valmat/BatterySensor/README.md

BatterySensor
=======
This is my personal Arduino project. Its purpose is to expand the functionality of the battery for the boat motor.

Used libraries:

*	[Pino](https://github.com/valmat/Pino)
*	[LiquidCrystal](https://github.com/arduino/Arduino/tree/master/libraries/LiquidCrystal)
*	[RBD_Button](https://github.com/alextaujenis/RBD_Button)
*	[RBD_Timer](https://github.com/alextaujenis/RBD_Timer)
*	[Wire](https://www.arduino.cc/en/Reference/Wire)
*	[Adafruit_BMP085_Library](https://github.com/adafruit/Adafruit-BMP085-Library)

Documentation is [here](https://github.com/valmat/BatterySensor/tree/master/docs) (russian)

---

Это мой персональный Aрдуино проект. Его предназначение заключается в расширении функциональности для лодочного матора.
Подробнее см. [моем блоге](http://www.valmat.ru/2016/02/batterySensor.html)
