valmat/BatterySensor/docs/my-pinout2.png

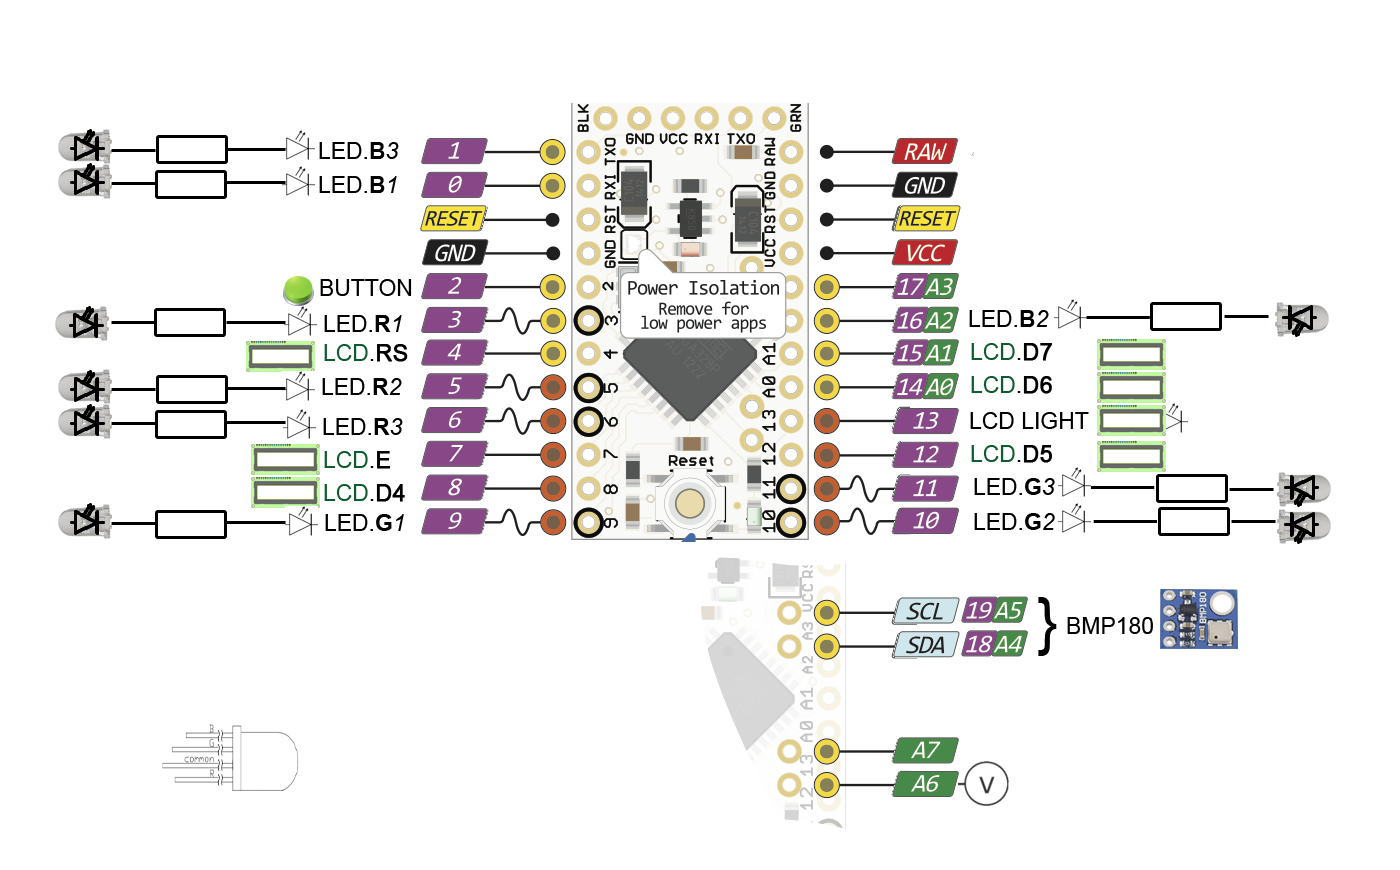
docs/my-pinout2.png
