valmat/BatterySensor/docs/my-pinout.png

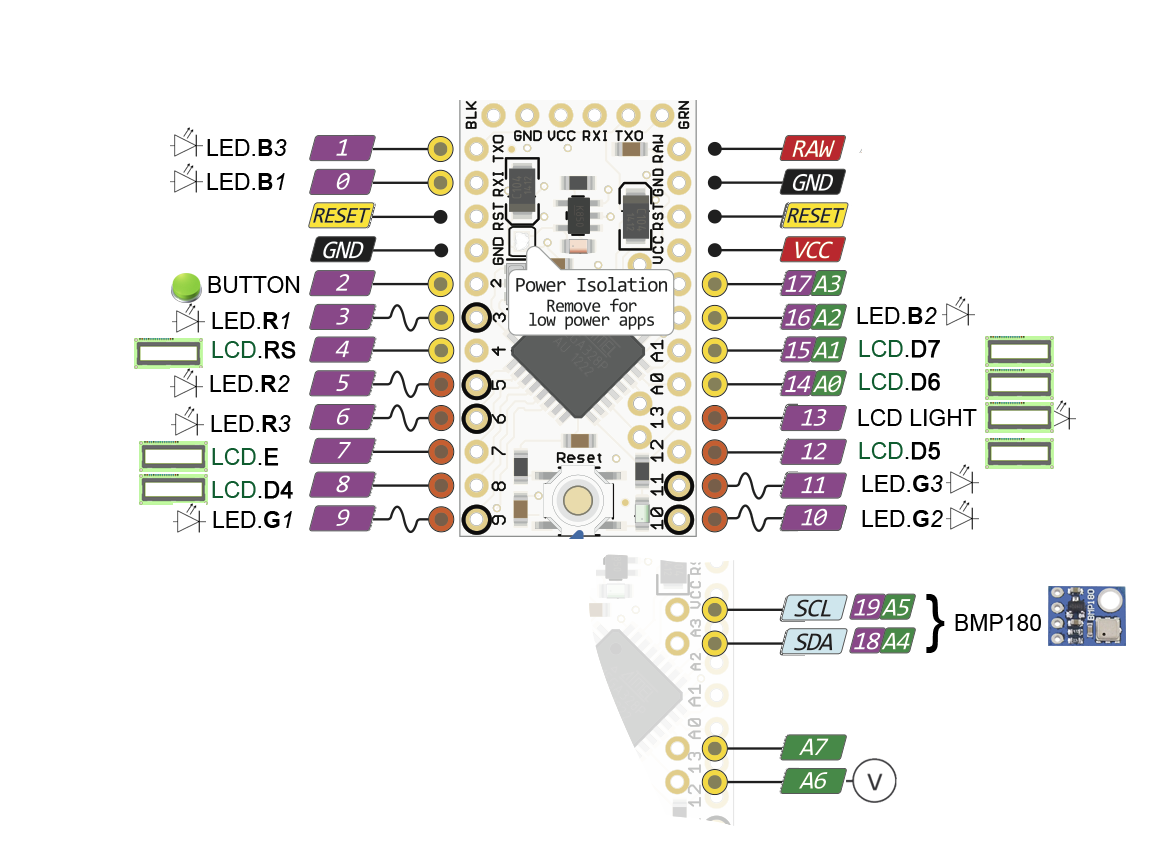
docs/my-pinout.png
