valmat/BatterySensor/docs/realScheme.png

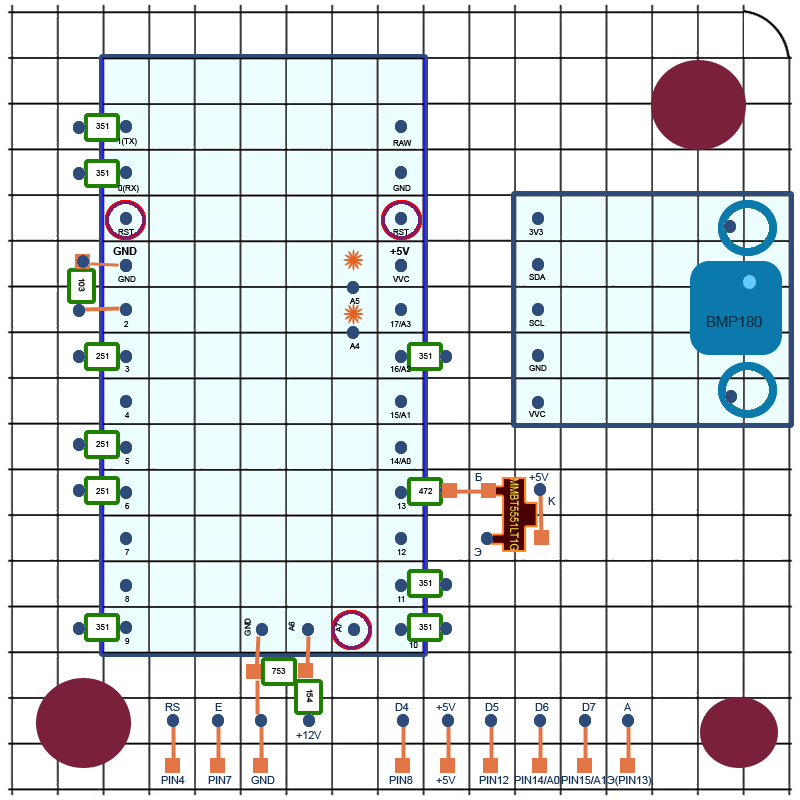
docs/realScheme.png
