valmat/BatterySensor/(commit log)

2016-02-09 Добавлен класс для удобного рисования символа заполненности батареи
2016-02-10 Добавил букву "Д"
2016-02-10 class LCDwrapper Обертка над LiquidCrystal для удобного отображения на экране
2016-02-10 Перенес все настройки в класс Configs
2016-02-10 Написан класс для определения состояния батарие class Battery
2016-02-10 переименован: PicBat.cpp -> MyGlyps.cpp переименован: PicBat.h -> MyGlyps.h
2016-02-10 Отображение значка батареи в зависимости от уровня заряда и некоторые другие мелкие улучшения
2016-02-10 Реализована индикация состояния батареи на светодиодах Добавлен класс LedBox
2016-02-11 Добавил возможность отключать с кнопки как подсветку экрана, так и LED индикацию
2016-02-11 Немного прибрался в коде
2016-02-18 новые файлы в документации
2016-02-18 Неправильно подобрал резисторы на светодиоды. Из-за этого белый цвет имеет желтоватый оттенок. Убрал отображение белого цвета.
2016-02-18 renamed: present23febrary.ino -> batterySensor.ino
2016-02-18 Перепутал местами 2-й и 3-й светодиоды. Поправил за счет изменения конфига.
2016-02-18 Increased button debounce time
2016-02-18 Удалил лишние файлы из каталога /doc
2016-02-18 Удалил исходники .psd & .odt
2016-02-18 calibration & corrected `LCDwrapper::printFract()`
    [Battery.h, Configs.h, LCDwrapper.cpp, batterySensor.ino]
2016-02-18 Добавил возможность выводить напряжение с двумя значащими цифрами после запятой
2016-02-18 Отображение значений напряжения и процента заряда, пригодное для релиз-версии
2016-02-18 Убрал мусор в `LCDwrapper::show()`
2016-02-18 Некоторые правки в конфигах
2016-02-18 Changed `LedBox::showBat()`
2016-02-18 class Averager Вывод среднего измеренного значения
2016-02-18 Пара косметических улучшений
2016-02-19 Поменял логику работы кнопки
2016-02-19 Увеличил продолжительность усреднения до 1 минуты
2016-02-19 Увеличил разрядность `totalAvarage`. Мало ли... Вдруг потом захочется усреднять на еще больший срок..
2016-02-21 Fixed class Averager template parameter size
    [Averager.h]
